thew0205/iot_air_quality_monitoring_system/iaq_firmware/docs/latex/wifi_8h.tex

\doxysection{/home/busoye\+\_\+tm/\+Documents/matthew/edinburgh\+\_\+project/iot\+\_\+air\+\_\+quality\+\_\+board/iaq\+\_\+firmware/src/wifi/wifi.h File Reference}
\hypertarget{wifi_8h}{}\label{wifi_8h}\index{/home/busoye\_tm/Documents/matthew/edinburgh\_project/iot\_air\_quality\_board/iaq\_firmware/src/wifi/wifi.h@{/home/busoye\_tm/Documents/matthew/edinburgh\_project/iot\_air\_quality\_board/iaq\_firmware/src/wifi/wifi.h}}

Header file for Wi\+Fi functionality.  

\doxysubsubsection*{Functions}
\begin{DoxyCompactItemize}
\item 
\Hypertarget{wifi_8h_ae53253105bdec46de3c448476271d28b}\label{wifi_8h_ae53253105bdec46de3c448476271d28b} 
void {\bfseries print\+Test} ()
\begin{DoxyCompactList}\small\item\em Prints a test message to the console. \end{DoxyCompactList}\end{DoxyCompactItemize}

\doxysubsection{Detailed Description}
Header file for Wi\+Fi functionality.
