thew0205/iot_air_quality_monitoring_system/iaq_firmware/docs/latex/wifi_8h_source.tex

\doxysection{wifi.\+h}
\hypertarget{wifi_8h_source}{}\label{wifi_8h_source}\index{/home/busoye\_tm/Documents/matthew/edinburgh\_project/iot\_air\_quality\_board/iaq\_firmware/src/wifi/wifi.h@{/home/busoye\_tm/Documents/matthew/edinburgh\_project/iot\_air\_quality\_board/iaq\_firmware/src/wifi/wifi.h}}
\mbox{\hyperlink{wifi_8h}{Go to the documentation of this file.}}
\begin{DoxyCode}{0}
\DoxyCodeLine{00001\ }
\DoxyCodeLine{00006\ \textcolor{preprocessor}{\#pragma\ once}}
\DoxyCodeLine{00007\ }
\DoxyCodeLine{00011\ \textcolor{keywordtype}{void}\ \mbox{\hyperlink{wifi_8h_ae53253105bdec46de3c448476271d28b}{printTest}}();}

\end{DoxyCode}
