thew0205/iot_air_quality_monitoring_system/others/images/pm2_5.png

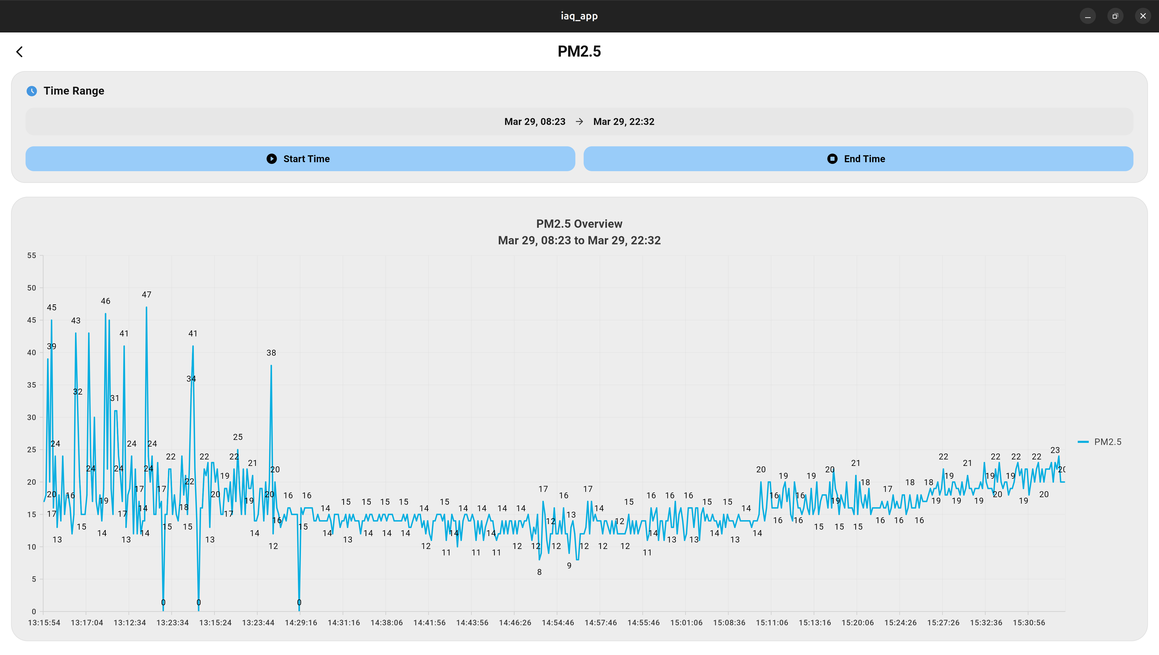
others/images/pm2_5.png
