thew0205/iot_air_quality_monitoring_system/iaq_firmware/tests/target/mqtt_integration_target/CMakeLists copy.txt

# Generated Cmake Pico project file

cmake_minimum_required(VERSION 3.13)

set(CMAKE_C_STANDARD 11)
set(CMAKE_CXX_STANDARD 17)
set(CMAKE_EXPORT_COMPILE_COMMANDS ON)

# Initialise pico_sdk from installed location
# (note this can come from environment, CMake cache etc)

# == DO NOT EDIT THE FOLLOWING LINES for the Raspberry Pi Pico VS Code Extension to work ==
if(WIN32)
    set(USERHOME $ENV{USERPROFILE})
else()
    set(USERHOME $ENV{HOME})
endif()
set(sdkVersion 2.1.1)
set(toolchainVersion 14_2_Rel1)
set(picotoolVersion 2.1.1)
set(picoVscode ${USERHOME}/.pico-sdk/cmake/pico-vscode.cmake)
if(EXISTS ${picoVscode})
    include(${picoVscode})
endif()
# ====================================================================================
set(PICO_BOARD pico_w CACHE STRING "Board type")

# Pull in Raspberry Pi Pico SDK (must be before project)
include(pico_sdk_import.cmake)

project(picow_mqtt_client C CXX ASM)

set(MQTT_SERVER "aj8uipcillvb-ats.iot.eu-west-2.amazonaws.com") # Change this to the host name of your MQTT server

set(WIFI_SSID "iaq_wifi")
set(WIFI_PASSWORD "1234567890")
set(MQTT_CERT_PATH ${CMAKE_CURRENT_LIST_DIR})

# Initialise the Raspberry Pi Pico SDK
pico_sdk_init()

add_executable(picow_mqtt_client
    mqtt_client.c
)
target_link_libraries(picow_mqtt_client
    pico_stdlib
    hardware_adc
    pico_cyw43_arch_lwip_threadsafe_background
    pico_lwip_mqtt
    pico_mbedtls
    pico_lwip_mbedtls

)
target_include_directories(picow_mqtt_client PRIVATE
    ${CMAKE_CURRENT_LIST_DIR}
    ${CMAKE_CURRENT_LIST_DIR}/.. # for our common lwipopts or any other standard includes, if required
)

target_compile_definitions(picow_mqtt_client PRIVATE
    WIFI_SSID=\"${WIFI_SSID}\"
    WIFI_PASSWORD=\"${WIFI_PASSWORD}\"
    MQTT_SERVER=\"${MQTT_SERVER}\"
)

target_compile_definitions(picow_mqtt_client PRIVATE
    MQTT_CERT_INC=\"${MQTT_CERT_INC}\" # contains the tls certificates for MQTT_SERVER needed by the client
    ALTCP_MBEDTLS_AUTHMODE=MBEDTLS_SSL_VERIFY_REQUIRED
)
target_include_directories(picow_mqtt_client PRIVATE
    ${MQTT_CERT_PATH}
)

pico_add_extra_outputs(picow_mqtt_client)

# Ignore warnings from lwip code
set_source_files_properties(
    ${PICO_LWIP_PATH}/src/apps/altcp_tls/altcp_tls_mbedtls.c
    PROPERTIES
    COMPILE_OPTIONS "-Wno-unused-result"
)

pico_enable_stdio_usb(picow_mqtt_client 1)
pico_enable_stdio_uart(picow_mqtt_client 1)
