thew0205/iot_air_quality_monitoring_system/iaq_hardware/Sensor Circuitry/Sensor Circuitry.kicad_sch

## KiCad design iaq_hardware/Sensor Circuitry/Sensor Circuitry.kicad_sch (2025-10-29)

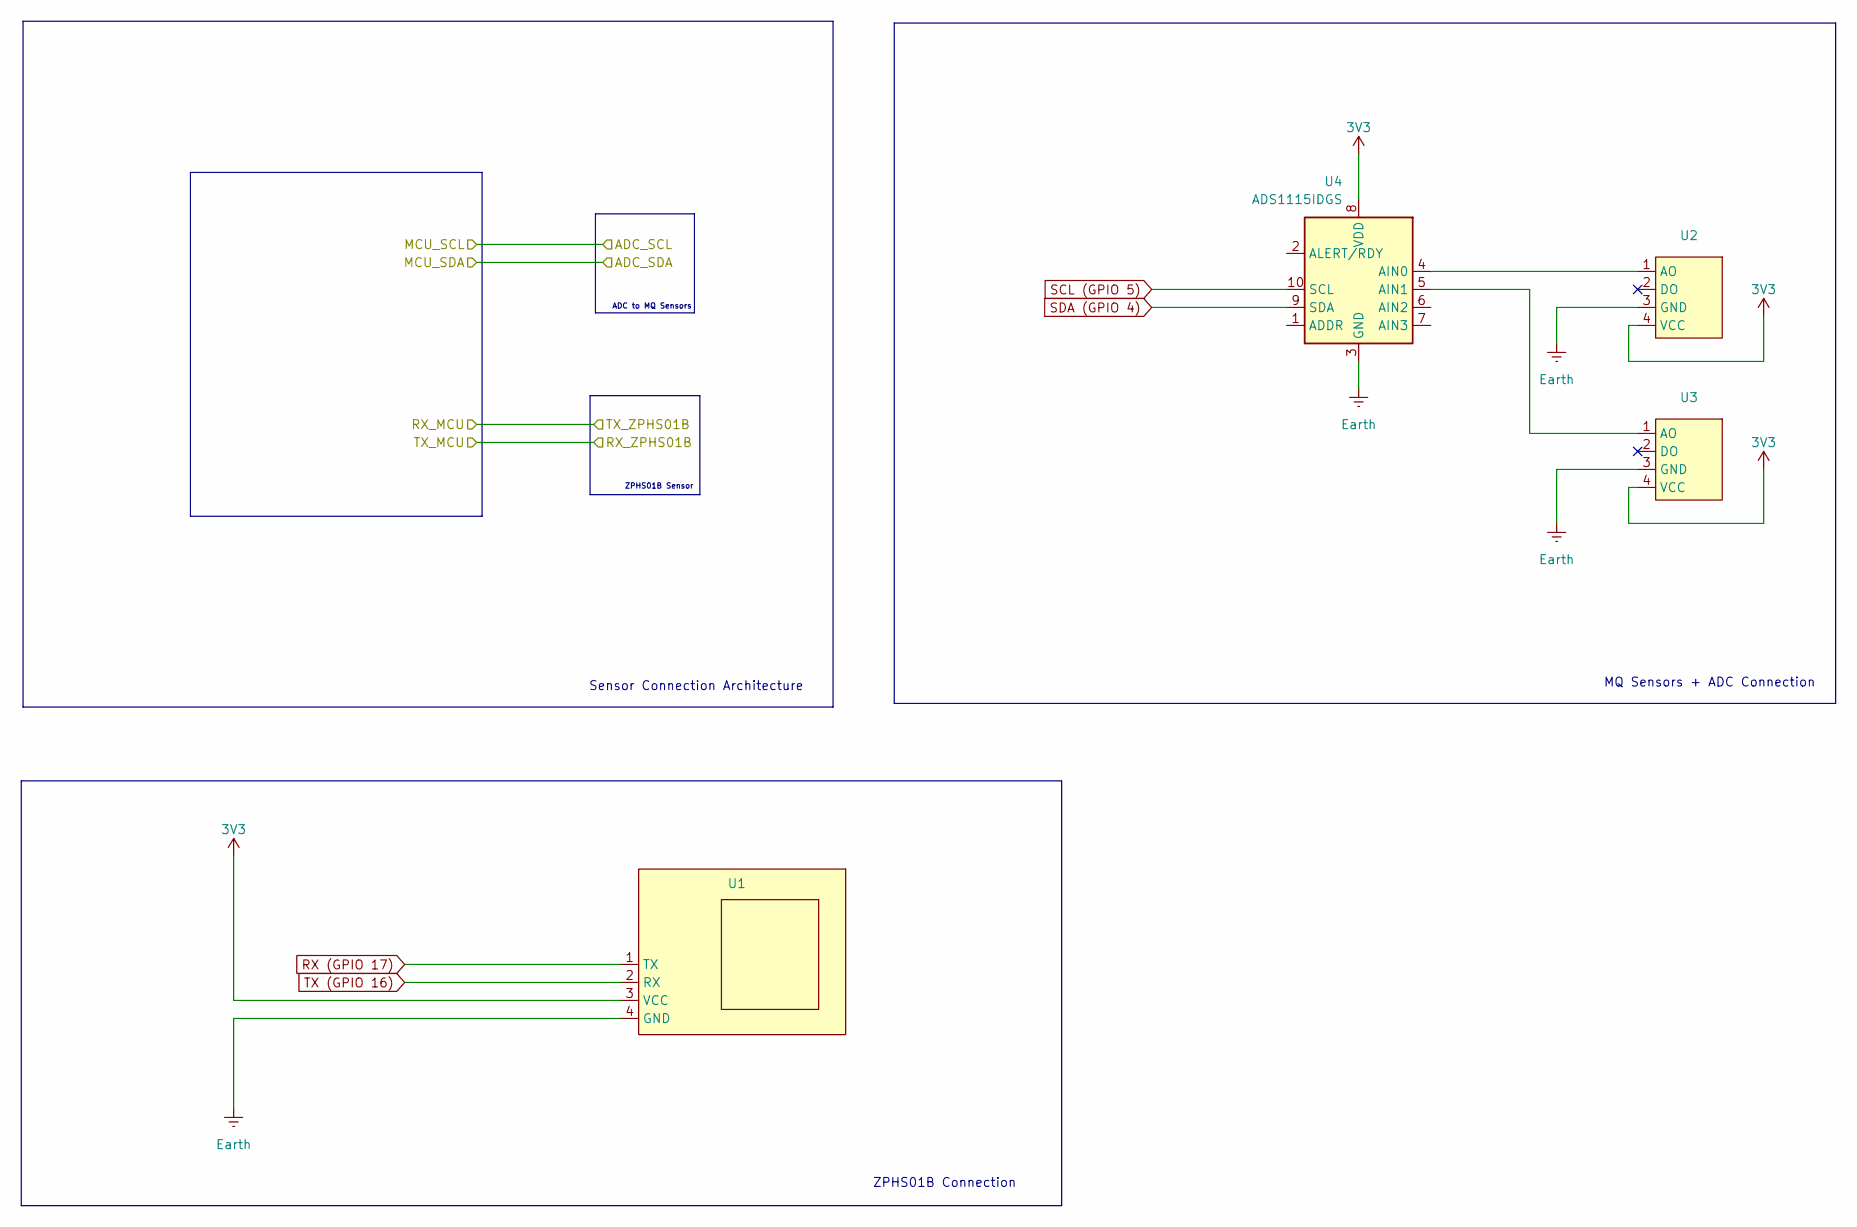
[picture p27: schematic Sensor Circuitry.kicad_sch]

Parts:
U1, U2, U3: (no value)
U4: ADS1115IDGS; TSSOP-10_3x3mm_P0.5mm

Connections:
3V3: U1.3 (VCC), U2.4 (VCC), U3.4 (VCC), U4.8 (VDD)
Earth: U1.4 (GND), U2.3 (GND), U3.3 (GND), U4.3 (GND)
unnamed: U2.1 (AO), U4.4 (AIN0)
unnamed: U3.1 (AO), U4.5 (AIN1)
RX (GPIO 17): U1.1 (TX)
SCL (GPIO 5): U4.10 (SCL)
SDA (GPIO 4): U4.9 (SDA)
TX (GPIO 16): U1.2 (RX)

Notes on the sheet:
ZPHS01B Sensor
Sensor Connection Architecture
ADC to MQ Sensors
MQ Sensors + ADC Connection
ZPHS01B Connection
