thew0205/iot_air_quality_monitoring_system/iaq_firmware/include/core_mqtt_config.h

/*
 * coreMQTT v2.3.1
 * Copyright (C) 2020 Amazon.com, Inc. or its affiliates.  All Rights Reserved.
 *
 * SPDX-License-Identifier: MIT
 *
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
 * THE SOFTWARE IS PROVIDED "AS IS", WITHOUT WARRANTY OF ANY KIND, EXPRESS OR
 * IMPLIED, INCLUDING BUT NOT LIMITED TO THE WARRANTIES OF MERCHANTABILITY, FITNESS
 * FOR A PARTICULAR PURPOSE AND NONINFRINGEMENT. IN NO EVENT SHALL THE AUTHORS OR
 * COPYRIGHT HOLDERS BE LIABLE FOR ANY CLAIM, DAMAGES OR OTHER LIABILITY, WHETHER
 * IN AN ACTION OF CONTRACT, TORT OR OTHERWISE, ARISING FROM, OUT OF OR IN
 * CONNECTION WITH THE SOFTWARE OR THE USE OR OTHER DEALINGS IN THE SOFTWARE.
 */

/**
 * @file core_mqtt_config.h
 * @brief This header sets configuration macros for the MQTT library.
 */
#ifndef CORE_MQTT_CONFIG_H_
#define CORE_MQTT_CONFIG_H_

/* Standard include. */
#include <stdint.h>

/**************************************************/
/******* DO NOT CHANGE the following order ********/
/**************************************************/

/* Include logging header files and define logging macros in the following order:
 * 1. Include the header file "logging_levels.h".
 * 2. Define the LIBRARY_LOG_NAME and LIBRARY_LOG_LEVEL macros depending on
 * the logging configuration for MQTT.
 * 3. Include the header file "logging_stack.h", if logging is enabled for MQTT.
 */

/* Logging configuration for the MQTT library. */
#ifndef LIBRARY_LOG_NAME
#define LIBRARY_LOG_NAME "CORE_MQTT"
#endif

#ifndef LIBRARY_LOG_LEVEL
#define LIBRARY_LOG_LEVEL LOG_DEBUG
#endif

/************ End of logging configuration ****************/

/**
 * @brief Retry count for reading CONNACK from network.
 *
 * #MQTT_Connect() can be using retries. If timeout passed as 0 to MQTT_Connect(),
 * retries are used to attempt to read from network. The maximum retry count is
 * specified by this config.
 *
 * These unit tests expect retrying only twice.
 */
#define MQTT_MAX_CONNACK_RECEIVE_RETRY_COUNT (2U)

#define MQTT_SUB_UNSUB_MAX_VECTORS (6U)

#define MQTT_SEND_TIMEOUT_MS (2000U)

#define MQTT_PINGRESP_TIMEOUT_MS (20000U)

// #include <stdio.h>
// #define LogError(...) printf(LIBRARY_LOG_NAME ": "); printf __VA_ARGS__; printf("\n");
// #define LogWarn(...) printf(LIBRARY_LOG_NAME ": "); printf __VA_ARGS__; printf("\n");
// #define LogDebug(...) printf(LIBRARY_LOG_NAME ": "); printf __VA_ARGS__; printf("\n");
// #define LogInfo(...) printf(LIBRARY_LOG_NAME ": "); printf __VA_ARGS__; printf("\n");

#endif /* ifndef CORE_MQTT_CONFIG_H_ */
