thew0205/iot_air_quality_monitoring_system/(commit log)

2025-08-02 Added Kicad Project
    [iot_air_quality_board.kicad_pcb, iot_air_quality_board.kicad_sch]
2025-08-21 Setup the project structure
    [iaq_hardware.kicad_pcb, iaq_hardware.kicad_sch]
2025-10-09 Updated build and sensor integration
2025-10-10 Fixed ZPHS01B sensor's error logging
    [sensors.cpp, sensors.h]
2025-10-23 Made the sensor code dual platform.
2025-10-23 Restructure the host code to use pico sdk host port.
2025-10-27 Fixed linker issue hindering build
    [adc_interface.cpp, sensors.cpp]
2025-10-29 Sensor harware design files upload
    [Sensor Circuitry.kicad_pcb, Sensor Circuitry.kicad_sch]
2025-10-29 Sensor hardware design files
    [Sensor Circuitry.kicad_pcb, Sensor Circuitry.kicad_sch]
2025-10-31 Minor edits to make build run on my board type (pico2)
2025-11-22 Implemented sensor valid check sum test.
2025-11-22 Integrated sensor and storages system.
2025-11-22 Updated the units of sensor readings
2025-11-22 Changed rtc i2c from i2c0 to i2c1 and pins to 6 & 7.
2025-11-22 Fixed the issue with the day of the week causing crash.
    [rtc_io_interface.cpp]
2025-11-26 Refactored Sensor data structure and update ADC handling for improved accuracy in readings
