thew0205/iot_air_quality_monitoring_system/(notices)

Notices in the files:
iaq_firmware/src/user_settings.h:
wolfSSL is free software; you can redistribute it and/or modify
it under the terms of the GNU General Public License as published by
the Free Software Foundation; either version 3 of the License, or
(at your option) any later version.
